mavric-teamiceman/mavric-teamiceman.github.io/software/pi/README.md

# PI
This is the main computional platform for the robot.

## src
The source folder in here contains all the software needed for the Raspberry Pi.
