mavric-teamiceman/mavric-teamiceman.github.io/images/Botalmostcomplete.jpg

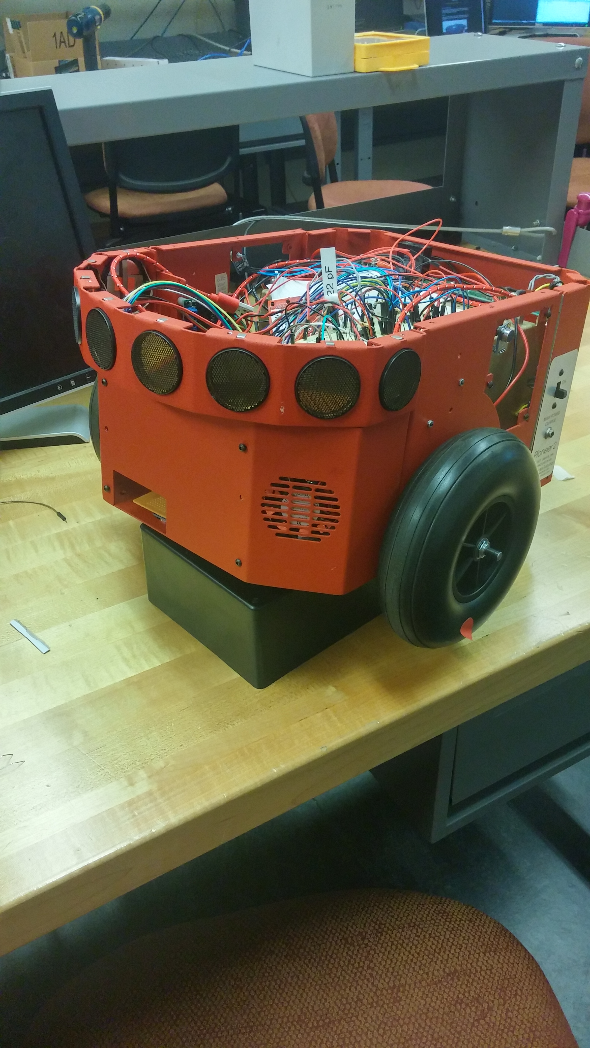
images/Botalmostcomplete.jpg
