mavric-teamiceman/mavric-teamiceman.github.io/images/CircuitDiagrams.png

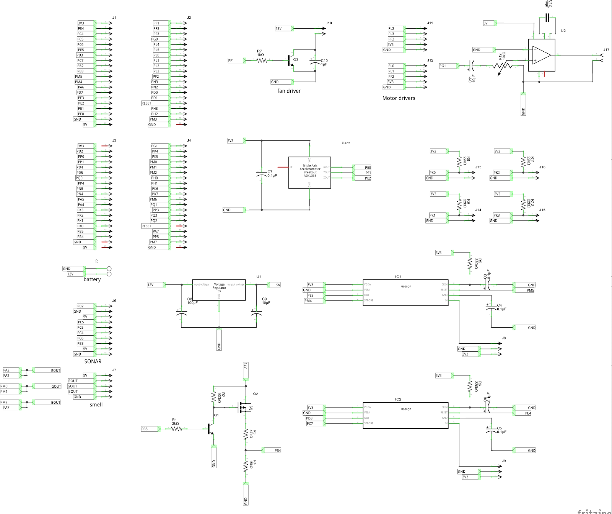
images/CircuitDiagrams.png
