mavric-teamiceman/mavric-teamiceman.github.io/images/DataExample.png

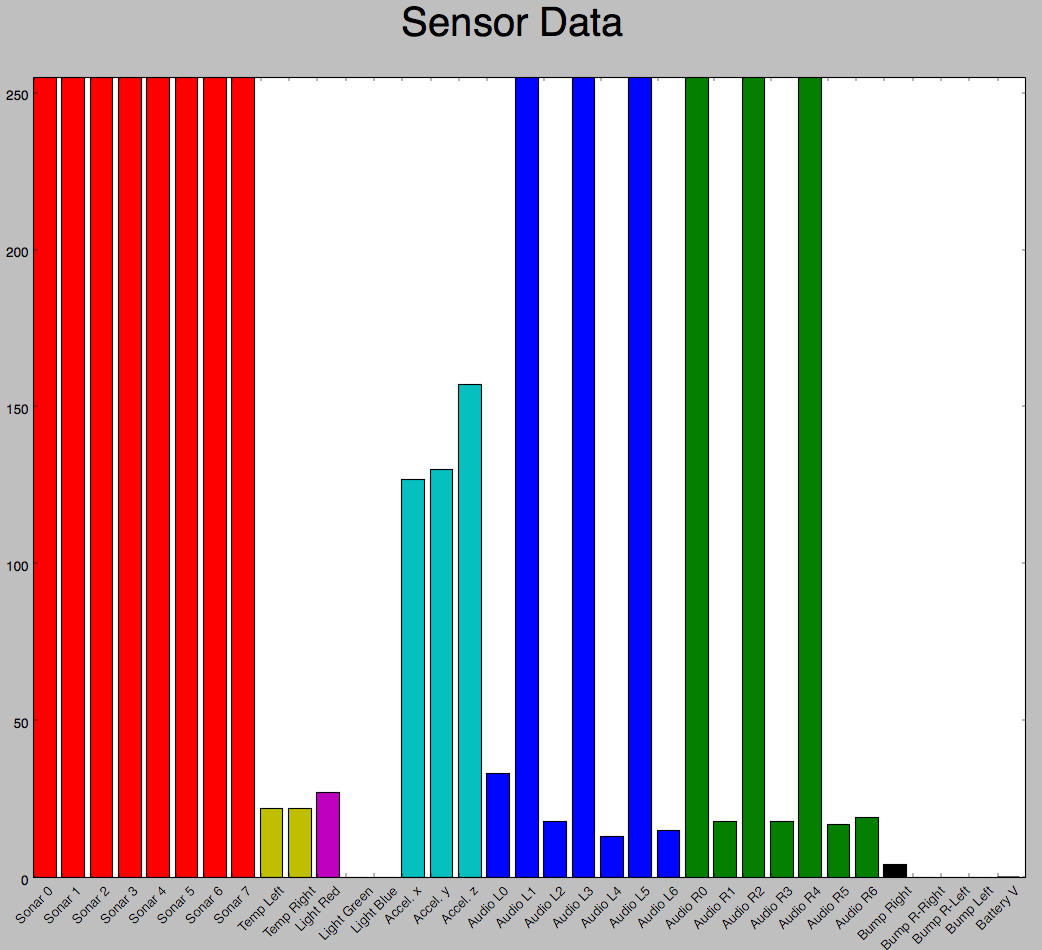
images/DataExample.png
