mavric-teamiceman/mavric-teamiceman.github.io/images/FinalPoster.png

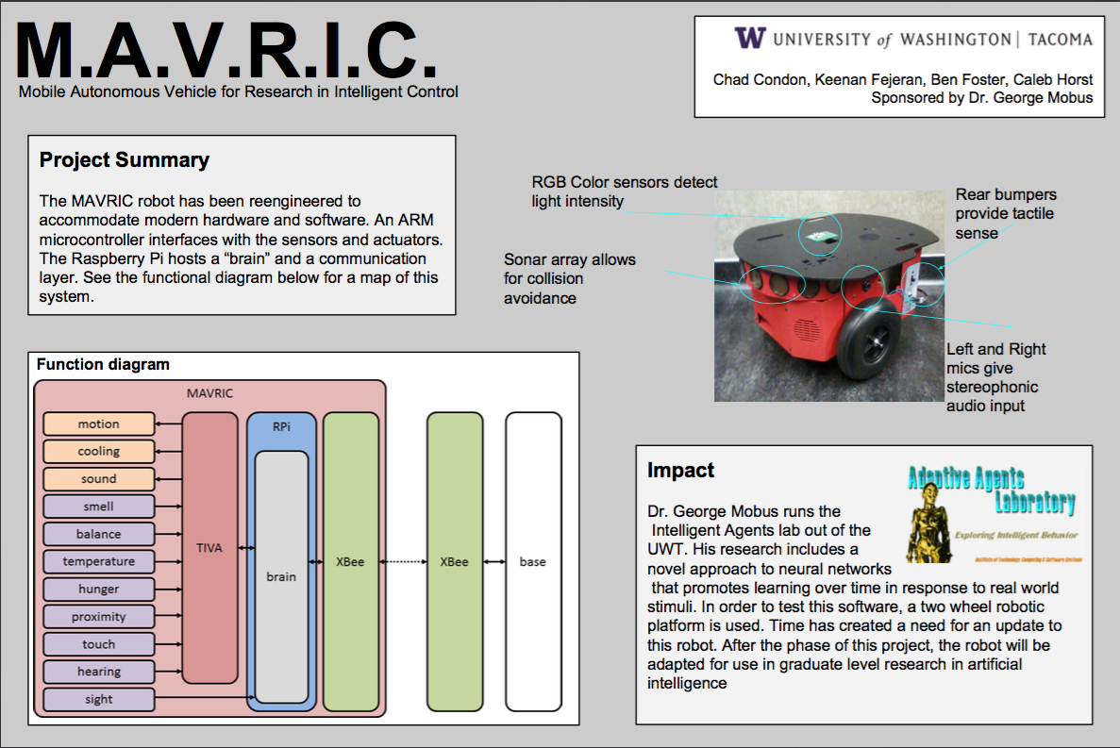
images/FinalPoster.png
