mavric-teamiceman/mavric-teamiceman.github.io/images/MAVRIC.png

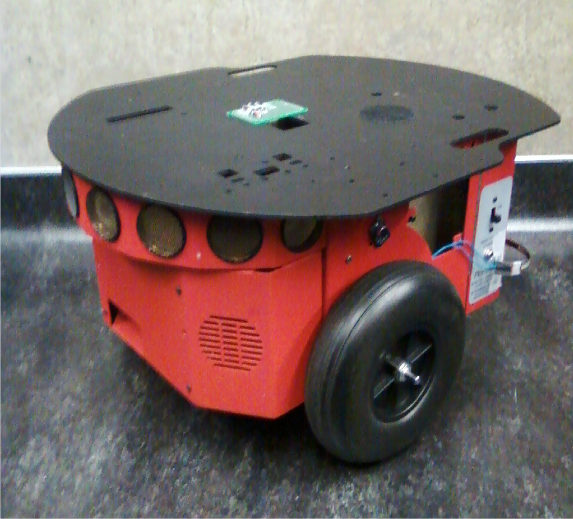
images/MAVRIC.png
