mavric-teamiceman/mavric-teamiceman.github.io/images/OnOffSwitch.jpg

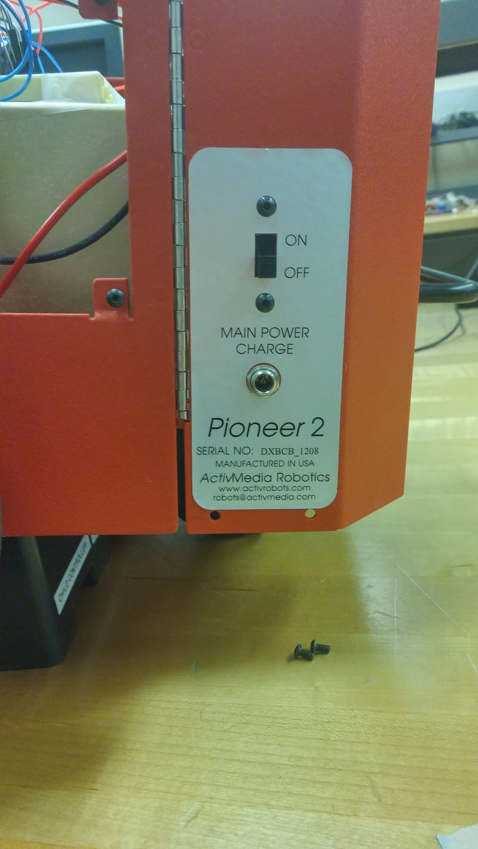
images/OnOffSwitch.jpg
