mavric-teamiceman/mavric-teamiceman.github.io/images/RatsNest.jpg

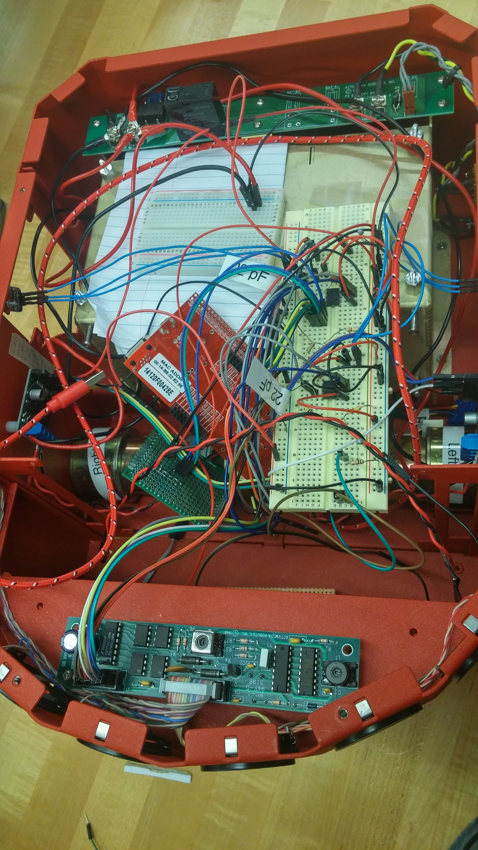
images/RatsNest.jpg
