mavric-teamiceman/mavric-teamiceman.github.io/doc/ipr1/src/bom.tex

{\footnotesize
\begin{tabular}{llrrr}
                                                            &&                  & \textbf{Cost per}     &                       \\
    \multicolumn{2}{l}{\textbf{Item}}			& \textbf{Count}    & \textbf{Item}         & \textbf{Cost}         \\ \hline
    MAX4466 & electret microphone amplifier                 & 2                 & 16.00                 & 32.00                 \\
    MSGEQ7 & graphic equalizer display filter               & 2                 & 4.95                  & 9.90                  \\
    TM4C1294 LaunchPad & microcontroller board              & 1                 & 19.99                 & 19.99                 \\
    Raspberry Pi B+ & single board computer                 & 1                 & 29.99                 & 29.99                 \\
    ADXL335 & triple axis accelerometer                     & 1                 & 14.99                 & 14.99                 \\
    TSL235 & light-to-frequency converter                   & 3                 & ---                   & ---                   \\
    ATtiny85 & slave microcontroller                        & 1                 & ---                   & ---                   \\
    HC-SR04 & distance sensor                               & 1                 & 5.00                  & 5.00                  \\
    MCC7805 & \SI{5}{\volt} positive voltage regulator      & 1                 & ---                   & ---                   \\
    XBee Pro 900 RPSMA & wireless transceiver               & 2                 & ---                   & ---                   \\
    M891 & leaded NTC thermistor                            & 2                 & ---                   & ---                   \\
    ActivMedia Pioner 2 & chassis                           & 1                 & ---                   & ---                   \\
    PS-1270 & battery                                       & 2                 & ---                   & ---                   \\
    GM9236E132 & \SI{12}{\volt} DC motor                    & 2                 & ---                   & ---                   \\
    VNH5019A & motor controller                             & 2                 & ---                   & ---                   \\
    Wombat (PTH) & prototyping board                        & 4                 & 9.95                  & 39.80                 \\
    \multicolumn{2}{l}{Raspberry Pi Camera Board}           & 1                 & 25.00                 & 25.00                 \\
    FS7548 & flex sensor                                    & 4                 & 12.95                 & 51.80                 \\
    TIP122 & NPN Darlington transistor                      & 1                 & 0.66                  & 0.66                  \\
    \multicolumn{2}{l}{various resistors, capacitors, wire, etc.} & ---               & ---                   & ---                   \\ \hline
    \multicolumn{4}{r}{\textbf{Total}}                                                                  & 229.13                \\ \hline
\end{tabular}
Items without a cost are on hand.
}
