mavric-teamiceman/mavric-teamiceman.github.io/doc/bom/billofmaterials.xlsx

Item | Product | Supplier | Count | Price | Datasheet
light-to-frequency converter | TSL235 | (on hand) | 3 | $0.00 | https://www.ti.com/lit/ds/symlink/tsl235.pdf
5V positive voltage regulator | TO-220 | (on hand) | 1 | $0.00
chassis | ActivMedia Pioneer 2 | (on hand) | 1 | $0.00
battery | PS-1270 | (on hand) | 2 | $0.00
12V DC motor | GM9236E132 | (on hand) | 2 | $0.00
motor controller | VNH5019A | (on hand) | 2 | $0.00
wireless transceiver | XBee 1mW Wire Antenna - Series 1 | (on hand) | 2 | $0.00 | https://www.sparkfun.com/datasheets/Wireless/Zigbee/XBee-Datasheet.pdf
Camera | Raspberry Pi Camera Board | (on hand) | 1 | $0.00 | https://dlnmh9ip6v2uc.cloudfront.net/datasheets/Dev/RaspberryPi/ov5647_full.pdf
electret microphone amplifier | MAX4466 | adafruit (https://www.adafruit.com/products/1063) | 2 | $6.95 | https://www.adafruit.com/datasheets/MAX4465-MAX4469.pdf
Shipping (estimate) |  |  |  | $4.07
Sales Tax (6.5%) |  |  |  | $0.00
SUBTOTAL |  |  |  | $17.97
ultrasonic distance sensor | HC-SR04 | Amazon (http://www.amazon.com/SainSmart-HC-SR04-Ranging-Detector-Distance/dp/B004U8TOE6) | 1 | $5.56
Shipping (estimate) |  |  |  | $0.00
Sales Tax (6.5%) |  |  |  | $0.53
SUBTOTAL |  |  |  | $6.09
microcontroller board | TM4C1294 Connected LaunchPad | DigiKey (http://www.digikey.com/product-detail/en/EK-TM4C1294XL/296-37267-ND/4725808) | 1 | $20.76 | https://www.ti.com/lit/ug/spmu365a/spmu365a.pdf
NPN Darlington transistor | TIP122 | DigiKey (http://www.digikey.com/product-detail/en/TIP122/TIP122FS-ND/458797) | 1 | $0.66
Shipping (estimate) |  |  |  | $13.98
Sales Tax (6.5%) |  |  |  | $2.30
SUBTOTAL |  |  |  | $37.70
graphic equalizer display filter | MSGEQ7 | SparkFun (https://www.sparkfun.com/products/10468) | 2 | $4.95 | https://www.sparkfun.com/datasheets/Components/General/MSGEQ7.pdf
single board computer | Raspberry Pi B+ | SparkFun (https://www.sparkfun.com/products/12994) | 1 | $39.95 | https://cdn.sparkfun.com/datasheets/Dev/RaspberryPi/RPiB+datasheet.pdf
triple axis accelerometer | ADXL335 | SparkFun (https://www.sparkfun.com/products/9269) | 1 | $14.95 | http://www.sparkfun.com/datasheets/Components/SMD/adxl335.pdf
slave microcontroller | ATtiny85 | SparkFun (https://www.sparkfun.com/products/9378) | 1 | $2.84 | http://www.atmel.com/Images/Atmel-2586-AVR-8-bit-Microcontroller-ATtiny25-ATtiny45-ATtiny85_Datasheet.pdf
wireless transceiver | XBee 1mW Wire Antenna - Series 1 | SparkFun | 2 | $0.00 | https://www.sparkfun.com/datasheets/Wireless/Zigbee/XBee-Datasheet.pdf
leaded NTC thermistor | NTCLE100E3 | SparkFun (https://www.sparkfun.com/products/250) | 3 | $0.75 | https://dlnmh9ip6v2uc.cloudfront.net/datasheets/Sensors/Temp/ntcle100.pdf
flex sensor | FS7548 | SparkFun (https://www.sparkfun.com/products/8606) | 4 | $12.95 | https://www.sparkfun.com/datasheets/Sensors/Flex/FLEXSENSOR%28REVA1%29.pdf
4-pin female connectors | Polarized Connectors - Housing (4-Pin) | SparkFun (https://www.sparkfun.com/products/8097) | 6 | $0.45
4-pin male connectors | Polarized Connectors - Header (4-Pin) | SparkFun (https://www.sparkfun.com/products/8231) | 6 | $0.45
3-pin female connectors | Polarized Connectors - Housing (3-Pin) | SparkFun (https://www.sparkfun.com/products/8096) | 6 | $0.45
3-pin male connectors | Polarized Connectors - Header (3-Pin) | SparkFun (https://www.sparkfun.com/products/8232) | 6 | $0.45
Crimp pins |  | SparkFun (https://www.sparkfun.com/products/8100) | 2 | $1.95
DIP Sockets | DIP Sockets Solder Tail - 8-Pin | SparkFun (https://www.sparkfun.com/products/7937) | 4 | $0.50
FTDI cable | USB to TTL Serial Cable | SparkFun (https://www.sparkfun.com/products/12977) | 1 | $9.95
Male header | Break Away Headers - Straight | SparkFun (https://www.sparkfun.com/products/116) | 4 | $1.50
Shipping |  |  |  | $0.00
SUBTOTAL |  |  |  | $154.34
TOTAL |  |  |  | $216.10
