mavric-teamiceman/mavric-teamiceman.github.io/images/MainComponents.jpg

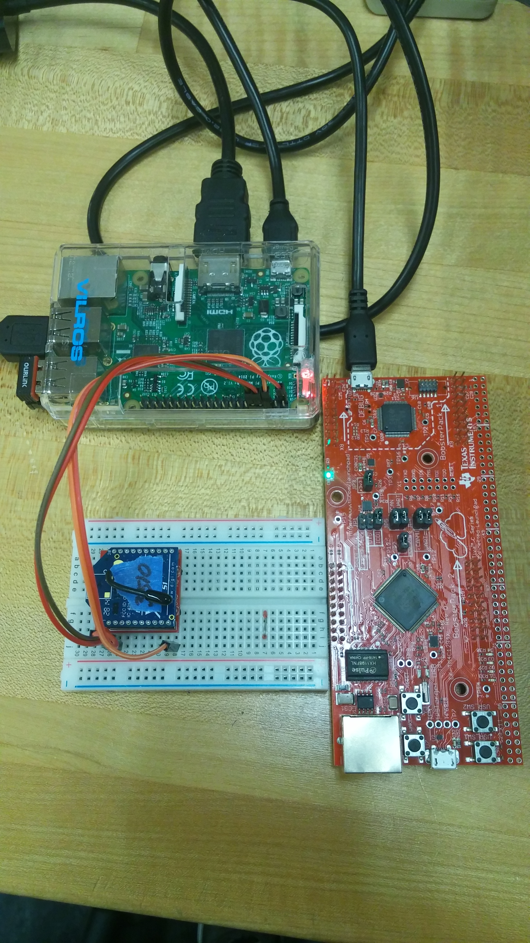
images/MainComponents.jpg
