mavric-teamiceman/mavric-teamiceman.github.io/schem/audio_in.sch

## KiCad design schem/audio_in.sch (2015-07-13)

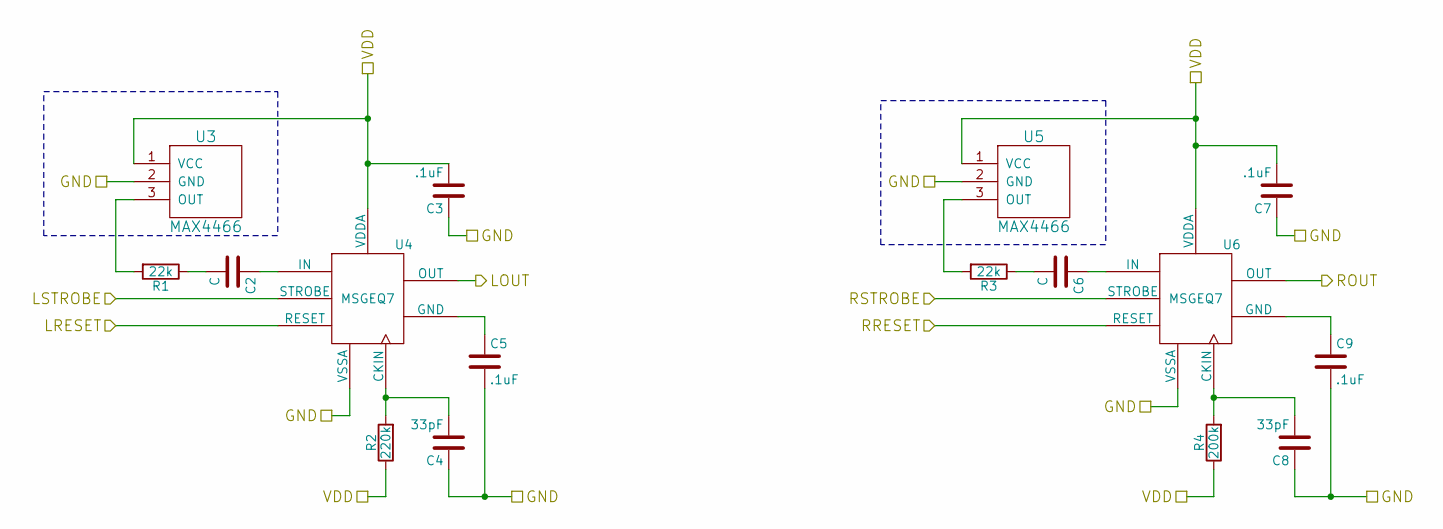
[picture p17: schematic audio_in.sch]

Parts:
C2, C6: C
C3, C5, C7, C9: .1uF
C4, C8: 33pF
R1, R3: 22k
R2: 220k
R4: 200k
U3, U5: MAX4466
U4, U6: MSGEQ7

Connections:
GND: C3.1, C4.1, C5.2, C7.1, C8.1, C9.2, U3.2 (GND), U4.2 (VSSA), U5.2 (GND), U6.2 (VSSA)
LOUT: U4.3 (OUT)
LRESET: U4.7 (RESET)
LSTROBE: U4.4 (STROBE)
unnamed: C2.1, U4.5 (IN)
unnamed: C2.2, R1.1
unnamed: C4.2, R2.2, U4.8 (CKIN)
unnamed: C5.1, U4.6 (GND)
unnamed: C6.1, U6.5 (IN)
unnamed: C6.2, R3.1
unnamed: C8.2, R4.2, U6.8 (CKIN)
unnamed: C9.1, U6.6 (GND)
unnamed: R1.2, U3.3 (OUT)
unnamed: R3.2, U5.3 (OUT)
ROUT: U6.3 (OUT)
RRESET: U6.7 (RESET)
RSTROBE: U6.4 (STROBE)
VDD: C3.2, C7.2, R2.1, R4.1, U3.1 (VCC), U4.1 (VDDA), U5.1 (VCC), U6.1 (VDDA)
