mavric-teamiceman/mavric-teamiceman.github.io/schem/audio_out.sch

## KiCad design schem/audio_out.sch (2015-07-13)

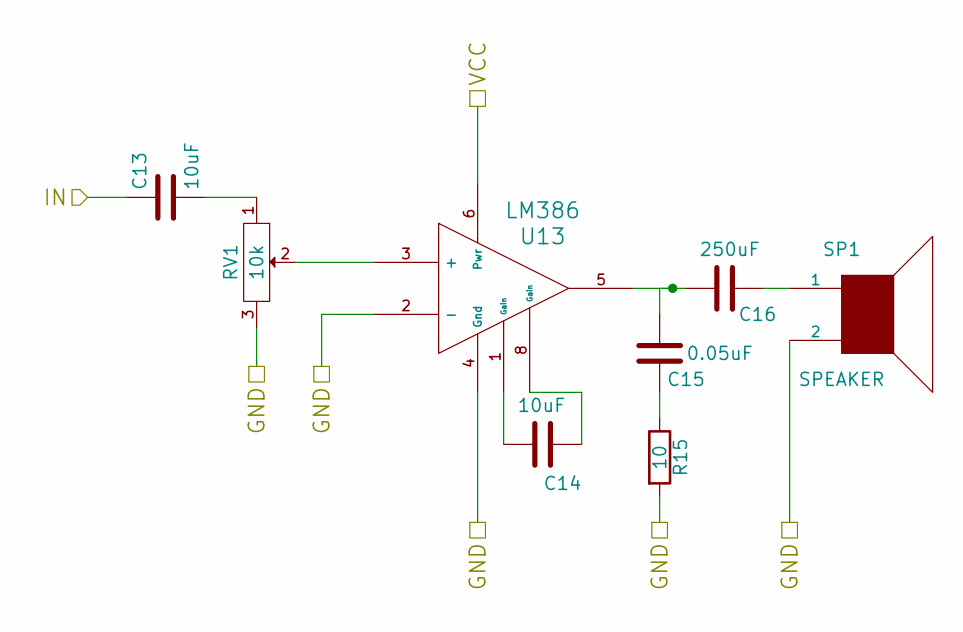
[picture p18: schematic audio_out.sch]

Parts:
C13, C14: 10uF
C15: 0.05uF
C16: 250uF
R15: 10
RV1: 10k
SP1: SPEAKER
U13: LM386

Connections:
GND: R15.2, RV1.3, SP1.2, U13.2 (-), U13.4 (Gnd)
IN: C13.1
unnamed: C13.2, RV1.1
unnamed: C14.1, U13.8 (Gain)
unnamed: C14.2, U13.1 (Gain)
unnamed: C15.1, R15.1
unnamed: C15.2, C16.2, U13.5
unnamed: C16.1, SP1.1
unnamed: RV1.2, U13.3 (+)
VCC: U13.6 (Pwr)
