mavric-teamiceman/mavric-teamiceman.github.io/schem/battery.sch

## KiCad design schem/battery.sch (2015-07-13)

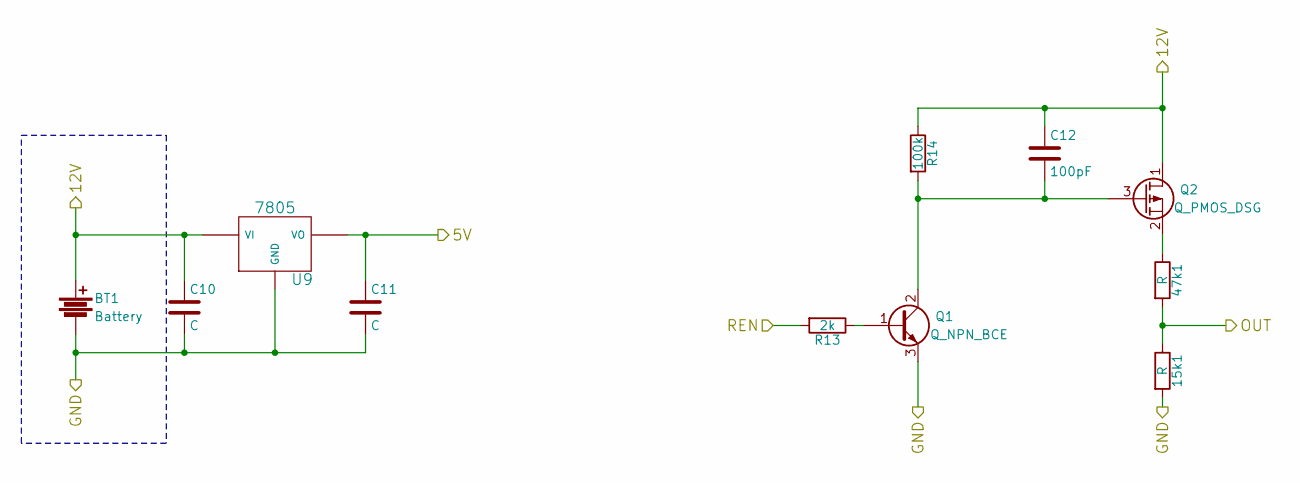
[picture p19: schematic battery.sch]

Parts:
15k1, 47k1: R
BT1: Battery
C10, C11: C
C12: 100pF
Q1: Q_NPN_BCE
Q2: Q_PMOS_DSG
R13: 2k
R14: 100k
U9: 7805

Connections:
5V: C11.1, U9.VO
12V: BT1.1, C10.1, C12.1, Q2.1 (D), R14.1, U9.VI
GND: 15k1.2, BT1.2, C10.2, C11.2, Q1.3 (E), U9.GND
unnamed: 47k1.1, Q2.2 (S)
unnamed: C12.2, Q1.2 (C), Q2.3 (G), R14.2
unnamed: Q1.1 (B), R13.1
OUT: 15k1.1, 47k1.2
REN: R13.2
