mavric-teamiceman/mavric-teamiceman.github.io/schem/bumpers.sch

## KiCad design schem/bumpers.sch (2015-07-13)

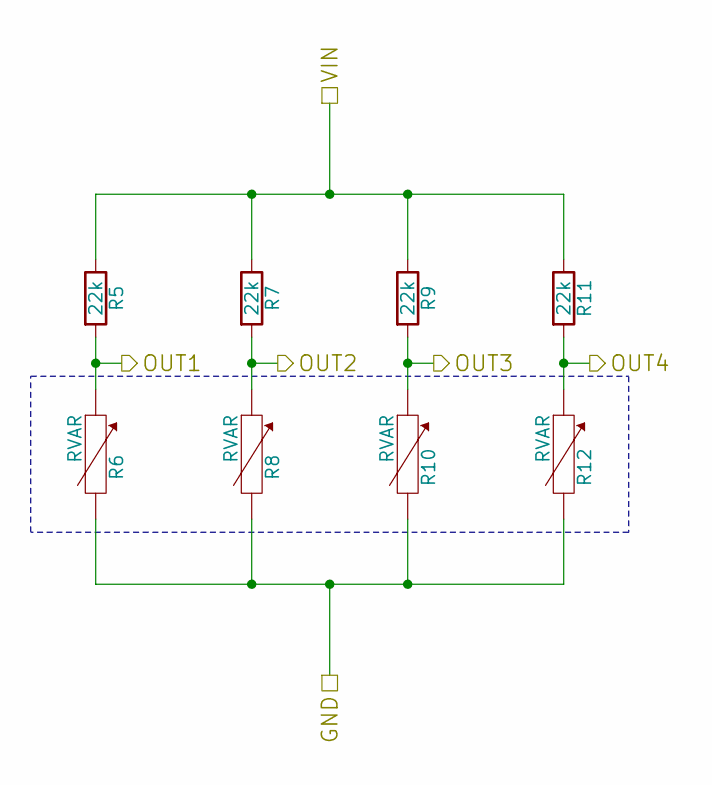
[picture p20: schematic bumpers.sch]

Parts:
R5, R7, R9, R11: 22k
R6, R8, R10, R12: RVAR

Connections:
GND: R6.2, R8.2, R10.2, R12.2
OUT1: R5.2, R6.1
OUT2: R7.2, R8.1
OUT3: R9.2, R10.1
OUT4: R11.2, R12.1
VIN: R5.1, R7.1, R9.1, R11.1
