mavric-teamiceman/mavric-teamiceman.github.io/schem/cliff.sch

## KiCad design schem/cliff.sch (2015-07-13)

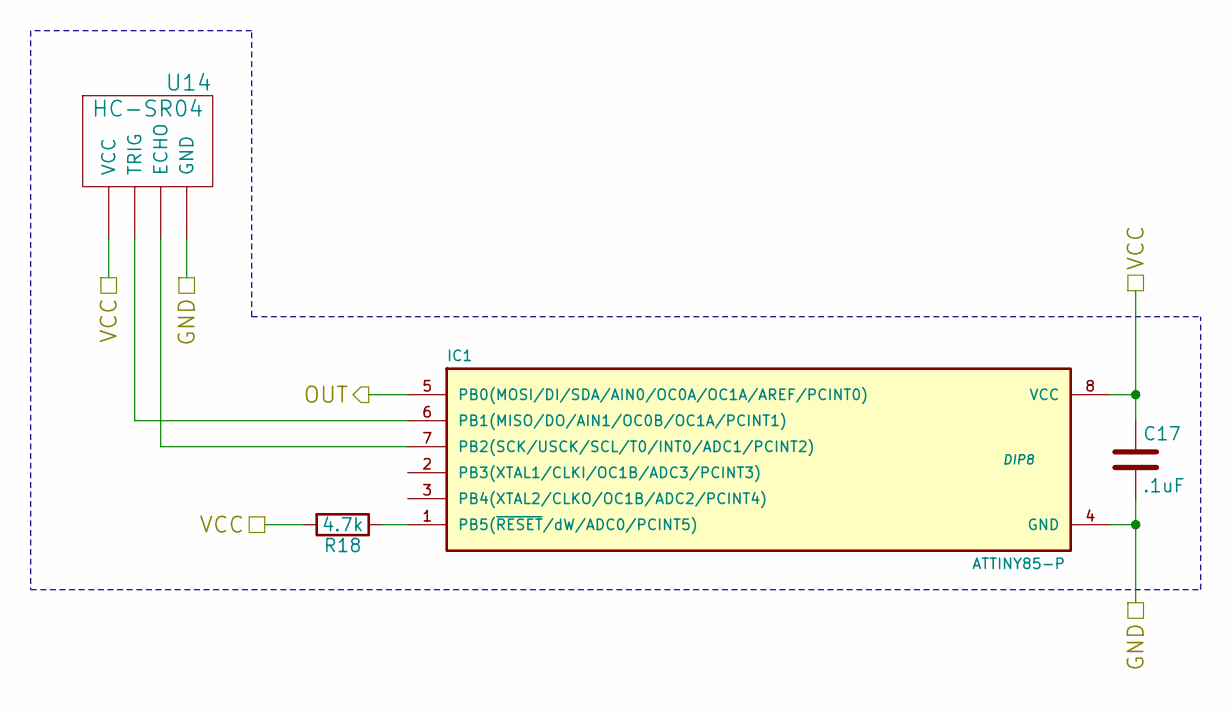
[picture p21: schematic cliff.sch]

Parts:
C17: .1uF
IC1: ATTINY85-P; DIP8
R18: 4.7k
U14: HC-SR04

Connections:
GND: C17.2, IC1.4 (GND), U14.~
unnamed: IC1.1 (PB5(~RESET~/dW/ADC0/PCINT5)), R18.1
unnamed: IC1.6 (PB1(MISO/DO/AIN1/OC0B/OC1A/PCINT1)), U14.~
unnamed: IC1.7 (PB2(SCK/USCK/SCL/T0/INT0/ADC1/PCINT2)), U14.~
OUT: IC1.5 (PB0(MOSI/DI/SDA/AIN0/OC0A/OC1A/AREF/PCI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)
VCC: C17.1, IC1.8 (VCC), R18.2, U14.~
