mavric-teamiceman/mavric-teamiceman.github.io/schem/fan.sch

## KiCad design schem/fan.sch (2015-07-13)

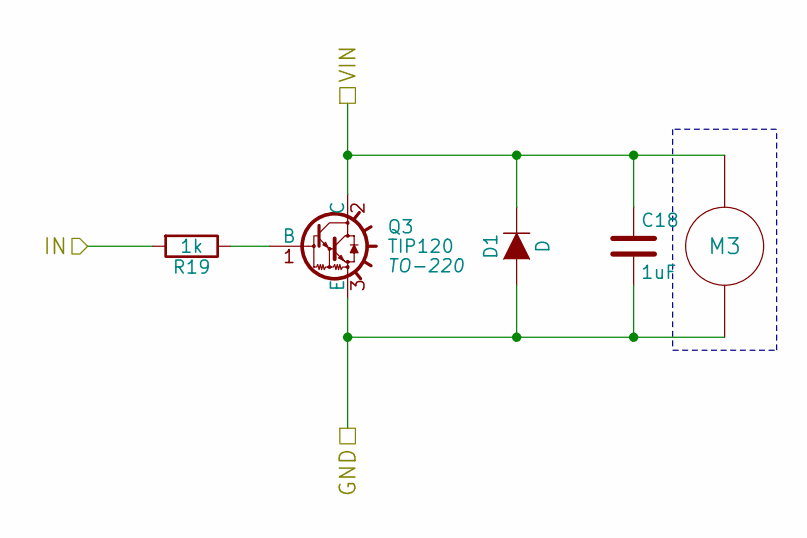
[picture p22: schematic fan.sch]

Parts:
C18: 1uF
D1: D
M3: Motor
Q3: TIP120; TO-220
R19: 1k

Connections:
GND: C18.2, D1.1 (A), M3.~, Q3.3 (E)
IN: R19.2
unnamed: Q3.1 (B), R19.1
VIN: C18.1, D1.2 (K), M3.~, Q3.2 (C)
