mavric-teamiceman/mavric-teamiceman.github.io/schem/mavric.sch

## KiCad design schem/mavric.sch (2015-07-13)

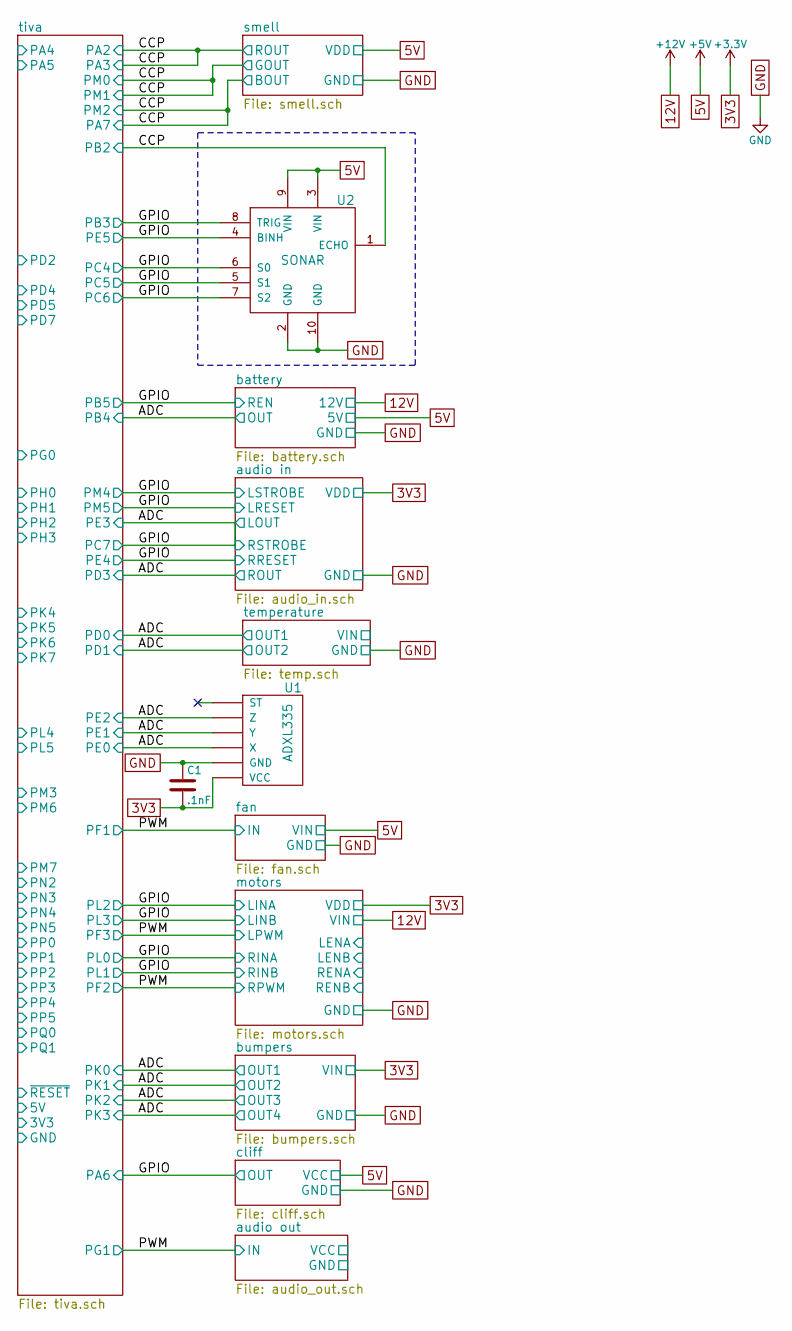
[picture p23: schematic mavric.sch]

Parts:
C1: .1nF
U1: ADXL335
U2: SONAR

Connections:
+3.3V: C1.2, U1.~
+5V: U2.3 (VIN), U2.9 (VIN)
ADC: U1.~, U2.4 (BINH), U2.5 (S1), U2.6 (S0), U2.7 (S2), U2.8 (TRIG)
CCP: U2.1 (ECHO)
GND: C1.1, U1.~, U2.2 (GND), U2.10 (GND)
