mavric-teamiceman/mavric-teamiceman.github.io/schem/motors.sch

## KiCad design schem/motors.sch (2015-07-13)

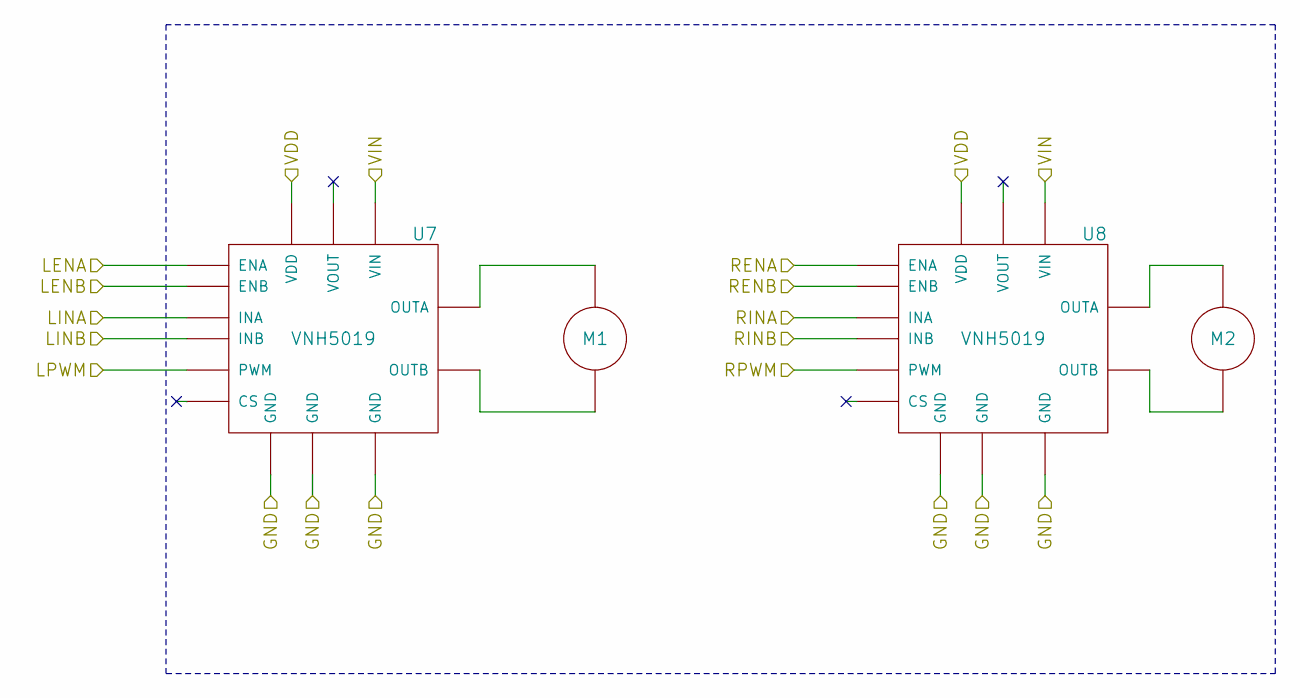
[picture p24: schematic motors.sch]

Parts:
M1, M2: Motor
U7, U8: VNH5019

Connections:
GND: U7.~, U8.~
LENA: U7.~
LENB: U7.~
LINA: U7.~
LINB: U7.~
LPWM: U7.~
unnamed: M1.~, U7.~
unnamed: M2.~, U8.~
RENA: U8.~
RENB: U8.~
RINA: U8.~
RINB: U8.~
RPWM: U8.~
VDD: U7.~, U8.~
VIN: U7.~, U8.~
