mavric-teamiceman/mavric-teamiceman.github.io/schem/smell.sch

## KiCad design schem/smell.sch (2015-07-13)

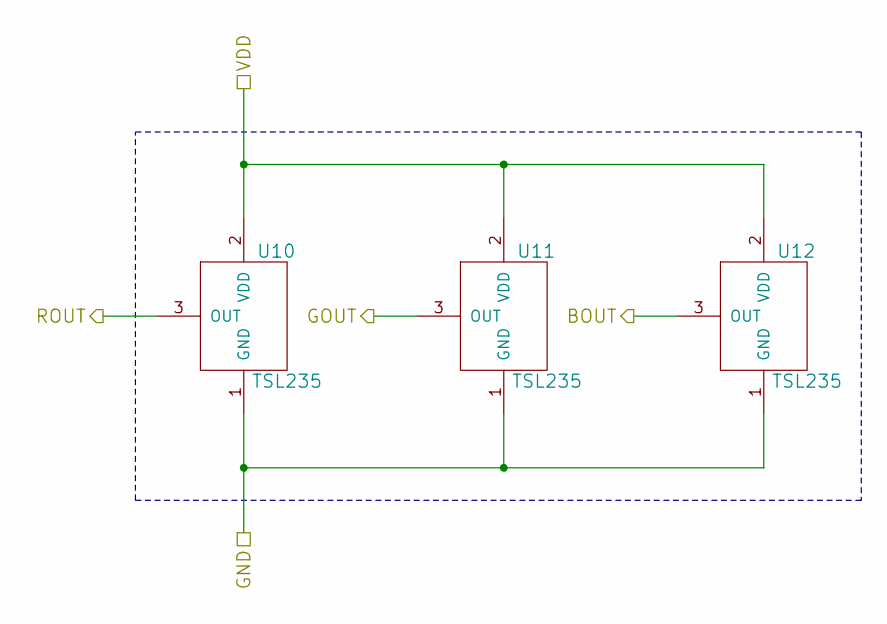
[picture p25: schematic smell.sch]

Parts:
U10, U11, U12: TSL235

Connections:
BOUT: U12.3 (OUT)
GND: U10.1 (GND), U11.1 (GND), U12.1 (GND)
GOUT: U11.3 (OUT)
ROUT: U10.3 (OUT)
VDD: U10.2 (VDD), U11.2 (VDD), U12.2 (VDD)
