mavric-teamiceman/mavric-teamiceman.github.io/schem/temp.sch

## KiCad design schem/temp.sch (2015-07-13)

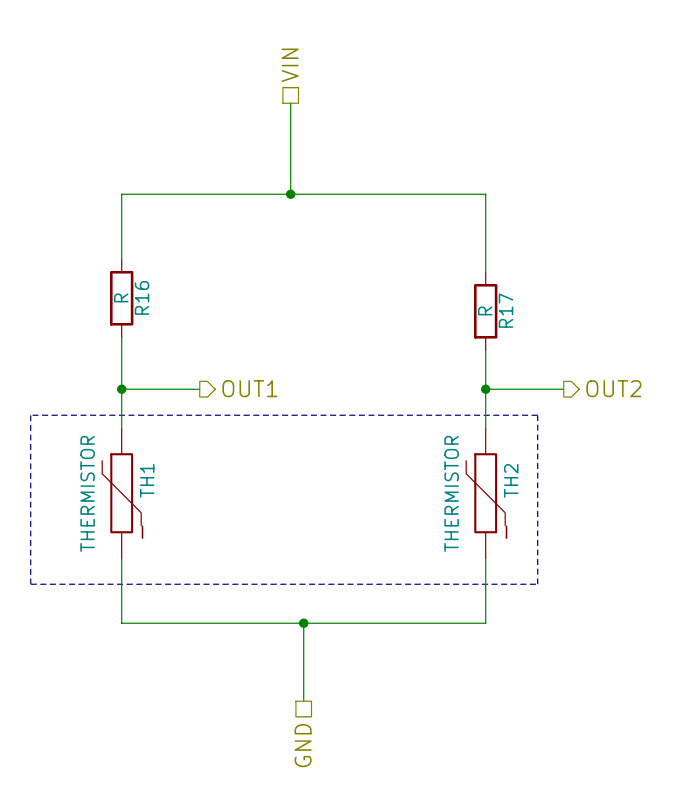
[picture p26: schematic temp.sch]

Parts:
R16, R17: R
TH1, TH2: THERMISTOR

Connections:
GND: TH1.2, TH2.2
OUT1: R16.2, TH1.1
OUT2: R17.2, TH2.1
VIN: R16.1, R17.1
