mavric-teamiceman/mavric-teamiceman.github.io/schem/tiva.sch

## KiCad design schem/tiva.sch (2015-07-13)

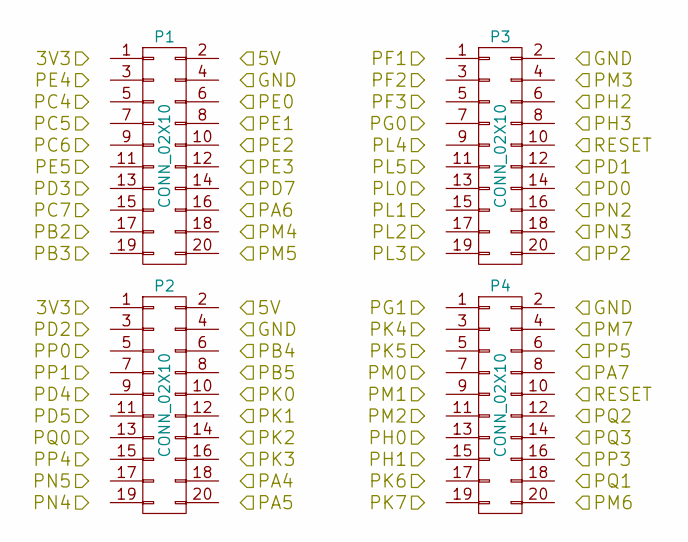
[picture p27: schematic tiva.sch]

Parts:
P1, P2, P3, P4: CONN_02X10
