mavric-teamiceman/mavric-teamiceman.github.io/software/tiva/src/bumper.h

/*
 * Iceman - 2015
 */


#ifndef BUMPER_H_
#define BUMPER_H_

//Left Pin K0
//Rear-Left Pin K1
//Rear-Right Pin K2
//Right Pin K3

int xInitializeBumperDriver();

void vBumperDriverTask();


#endif /* BUMPER_H_ */
