mavric-teamiceman/mavric-teamiceman.github.io/software/tiva/src/cliff.h

/*
 * Iceman - 2015
 *
 * cliff driver header
 */

#ifndef CLIFF_H_
#define CLIFF_H_


//Uses Pin A6

//0 is awesome, 1 is FAIL!!!
int xInitializeCliffDriver();

void vCliffISR();



#endif /* CLIFF_H_ */
